mtjacques/line-follower/linefollowerschematic.PNG

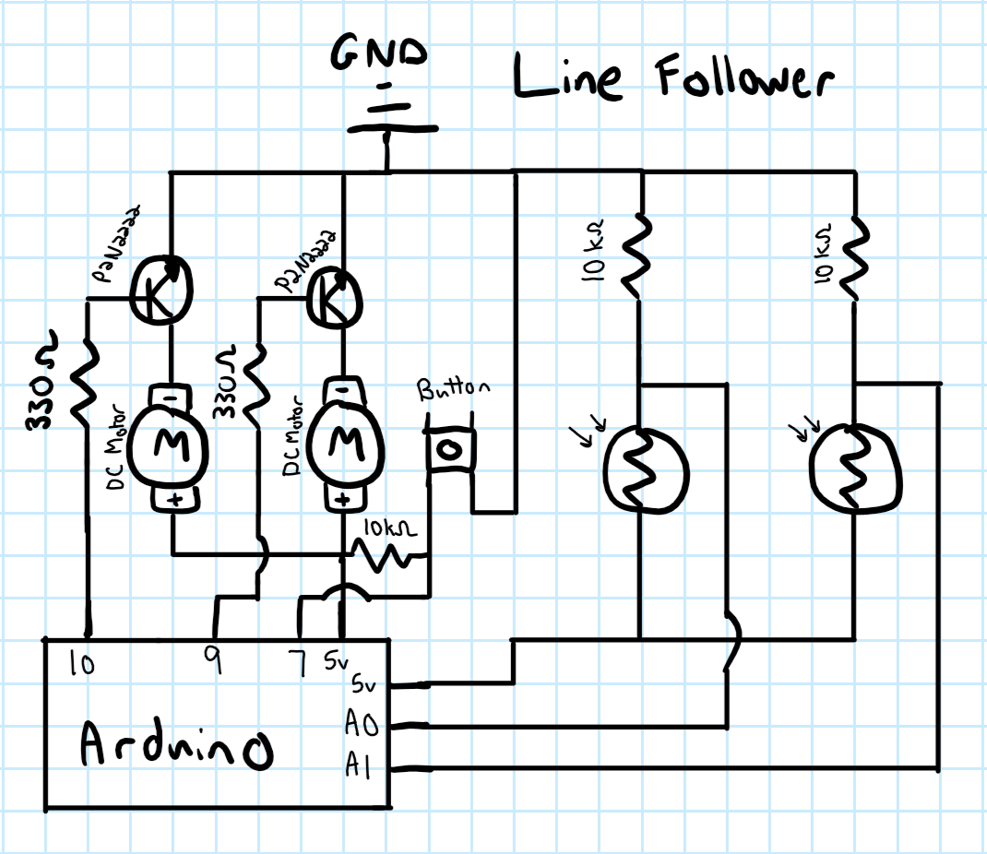
linefollowerschematic.PNG
